anonymous-k1wi/Robot-CAD-Files/Plastic Antweight/Ike!/Photos/20250421_222257.jpg

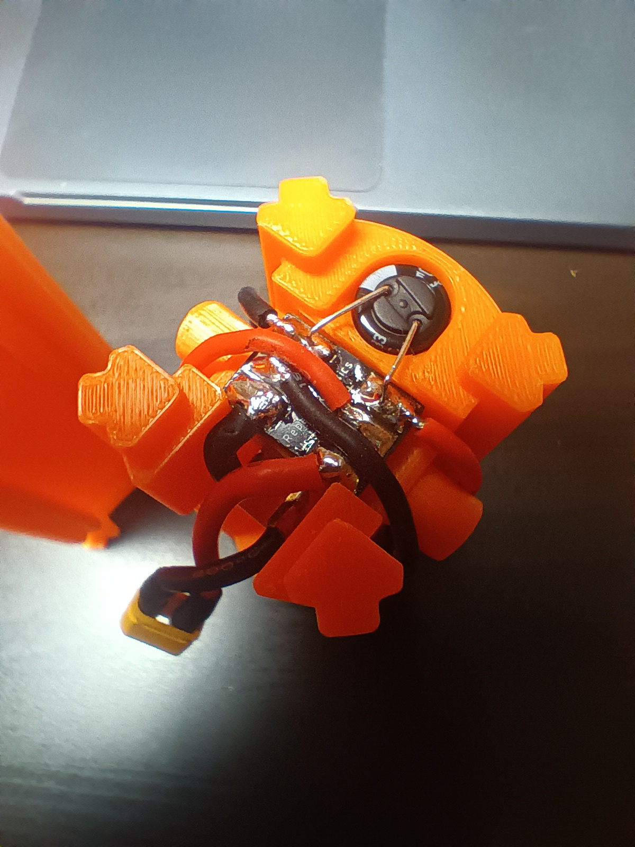
Plastic Antweight/Ike!/Photos/20250421_222257.jpg
