anonymous-k1wi/Robot-CAD-Files/Plastic Antweight/Ike!/Photos/20250419_141337.jpg

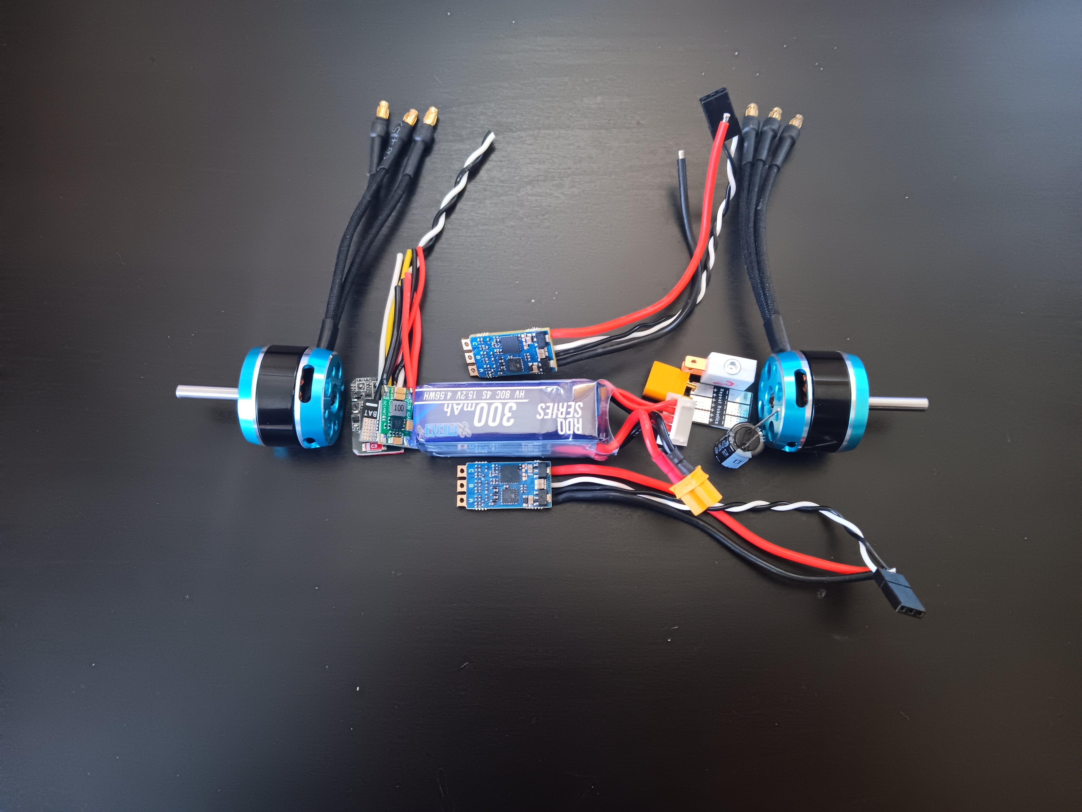
Plastic Antweight/Ike!/Photos/20250419_141337.jpg
