anonymous-k1wi/Robot-CAD-Files/Plastic Antweight/Citrus Twist/README.md

# Citrus Twist PLAnt Kit
This design was made and submitted to the [Repeat Robotics Open PLAnt Challenge](https://repeat-robotics.com/blogs/b/repeat-open-plant-challenge).  All electronics and hardware used to construct this kit can be found in the [Repeat Robotics Open PLAnt Bundle](https://repeat-robotics.com/products/open-plant-bundle), and all other parts are designed to be 3D printed from PLA+.



To get started, head to the [CAD & 3D Models](https://github.com/anonymous-k1wi/Robot-CAD-Files/tree/main/Plastic%20Antweight/Citrus%20Twist/CAD%20%26%203D%20Models) folder to download ready-to-go .3mf files (or individual .step files to setup and edit yourself), view the full CAD assembly, and download the [assembly manual](https://github.com/anonymous-k1wi/Robot-CAD-Files/blob/main/Plastic%20Antweight/Citrus%20Twist/Citrus%20Twist%20Assembly%20Manual.pdf).  Get building and have fun!

Has this been tested in the real world?  Yes!

Have you built this robot and want to have it added it to this list?  Make an RCE page and share the link and some pictures!



<sup> *[Momo](https://www.robotcombatevents.com/groups/5761/resources/39952)* </sup>
