anonymous-k1wi/Robot-CAD-Files/Plastic Antweight/Citrus Twist/CAD & 3D Models/Extras/Cast Wheels/README.md

These files are for those looking to forgo Lego wheels and make cast urethane wheels instead.
