anonymous-k1wi/Robot-CAD-Files/Plastic Antweight/Citrus Twist/CAD & 3D Models/Extras/2822 V2 Motor/README.md

If you have the older blue RR 2822 V2 motor, these files should be used instead of the main ones.  This is necessary due to the slightly altered mounting pattern for the screws.  All other parts remain the same.
