anonymous-k1wi/Robot-CAD-Files/Plastic Antweight/Citrus Twist/CAD & 3D Models/Basic Parts/README.md

# Citrus Twist Base Parts

## Recommended Print Settings

The print settings below are general recommended settings and are also contained in the .3mf files, but keep in mind they are intended to keep the robot slightly underweight by roughly ~20-25g.  After you've assembled and wired your first version and weighed the difference to the maximum weight (454g), add extra walls to the weapon ring to use up the remaining weight.  This will make the weapon stronger and hit harder.

| Part | Quantity | Wall Loops | Top/Bottom Layers | Infill Type | Infill % | Supports? | Approx. Weight (g) | 
| --- |:-:|:-:|:-:|:-:|:-:|:-:|:-:|
| core_lower.stp | 1x | 2 | 3 | Adaptive Cubic | 10% | No | 56g | 
| core_upper.stp | 1x | 2 | 3 | Adaptive Cubic | 10% | No | 25g | 
| weapon_ring.stp | 1x | 7 | 3 | Adaptive Cubic | 10% | Optional | 112g | 
| drive_gear.stp | 1x | 6 | 3 | Rectilinear | 40% | Yes | 13g |
| idler_gear.stp | 1x | 3 | 3 | Rectilinear | 40% | No | 3g | 
| wheel_hub.stp | 2x | 3 | 3 | Honeycomb | 10% | No | 5g |
| stabilizers.stp | 2x | 6 | 3 | Rectilinear | 40% | No | 2g |
| weapon_lock.stp | 1x | 4 | 3 | Rectilinear | 10% | No | NA |
