anonymous-k1wi/Robot-CAD-Files/Plastic Antweight/Citrus Twist/CAD & 3D Models/Basic Parts/Citrus Twist Assembly.stp

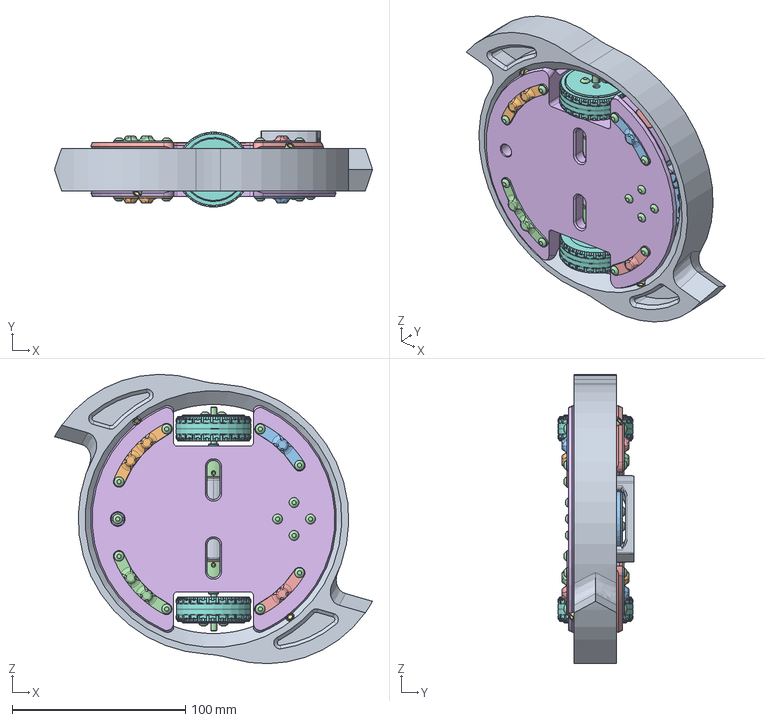
[picture p3: CAD file, 2026-10-29]
Plastic Antweight/Citrus Twist/CAD & 3D Models/Basic Parts/Citrus Twist Assembly.stp
183.3 x 43.8 x 166.8 mm
