anonymous-k1wi/Robot-CAD-Files/Plastic Antweight/Ike!/Ike_assembly.stp

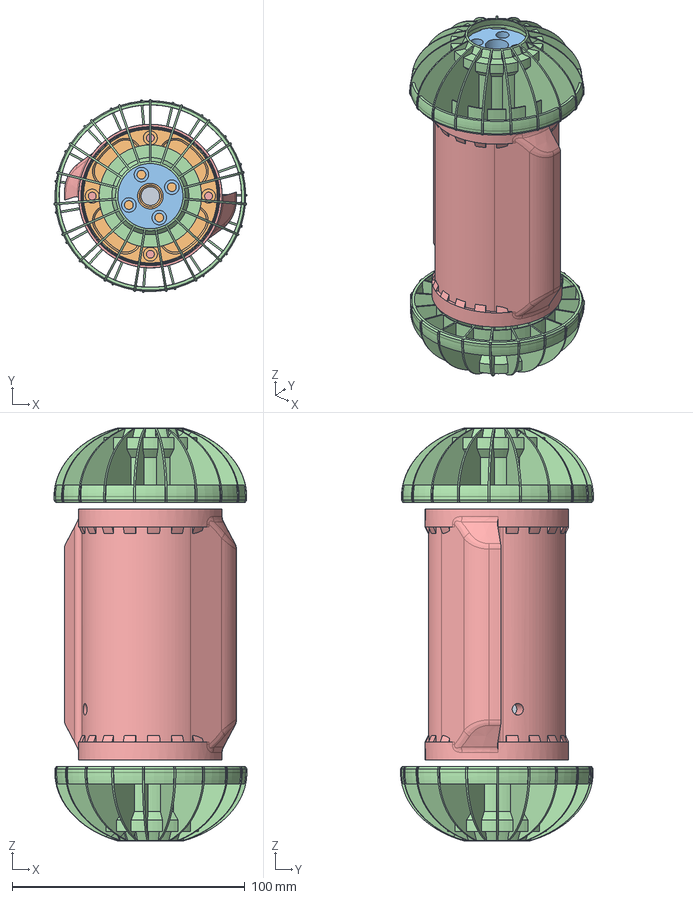
[picture p4: CAD file, 2026-06-19]
Plastic Antweight/Ike!/Ike_assembly.stp
82.9 x 82.9 x 177.5 mm
