anonymous-k1wi/Robot-CAD-Files/Plastic Antweight/Citrus Twist/CAD & 3D Models/Basic Parts/Individual Parts/weapon_lock.stp

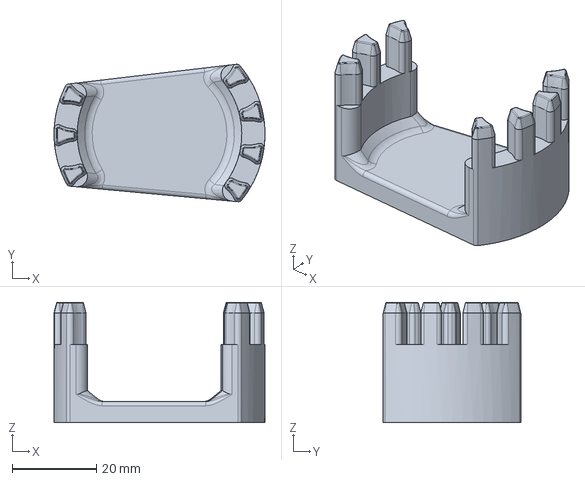
[picture p5: CAD file, 2026-10-29]
Plastic Antweight/Citrus Twist/CAD & 3D Models/Basic Parts/Individual Parts/weapon_lock.stp
50.0 x 32.6 x 28.5 mm
