anonymous-k1wi/Robot-CAD-Files/Plastic Antweight/Citrus Twist/CAD & 3D Models/Extras/2822 V2 Motor/drive_gear_mk2.stp

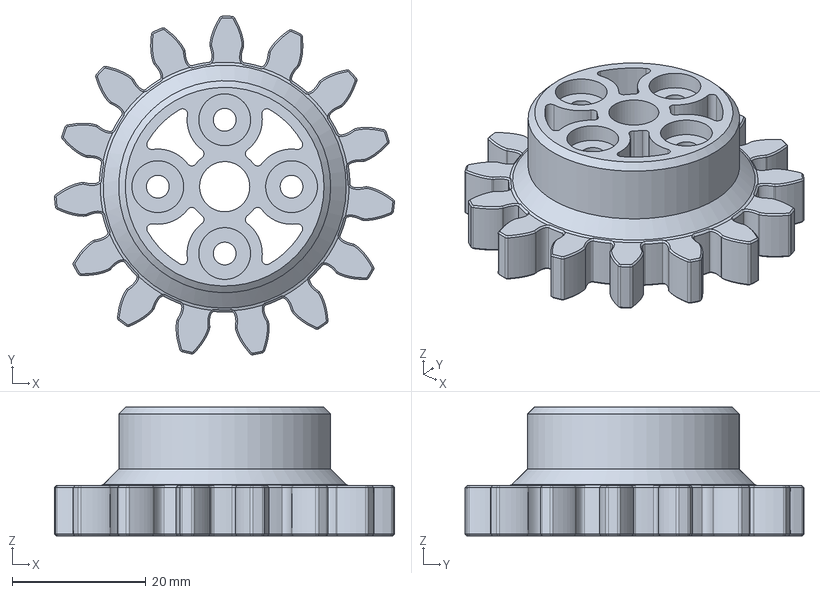
[picture p6: CAD file, 2026-11-01]
Plastic Antweight/Citrus Twist/CAD & 3D Models/Extras/2822 V2 Motor/drive_gear_mk2.stp
50.8 x 50.7 x 19.2 mm
