anonymous-k1wi/Robot-CAD-Files/Plastic Antweight/Citrus Twist/CAD & 3D Models/Extras/Cast Wheels/mold.stp

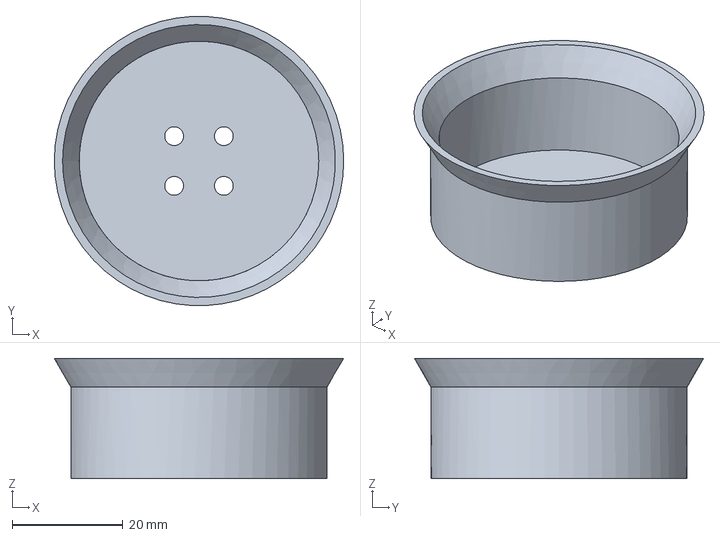
[picture p7: CAD file, 2026-11-01]
Plastic Antweight/Citrus Twist/CAD & 3D Models/Extras/Cast Wheels/mold.stp
52.3 x 52.2 x 21.7 mm
