anonymous-k1wi/Robot-CAD-Files/Plastic Antweight/Citrus Twist/CAD & 3D Models/Extras/display_stand.stp

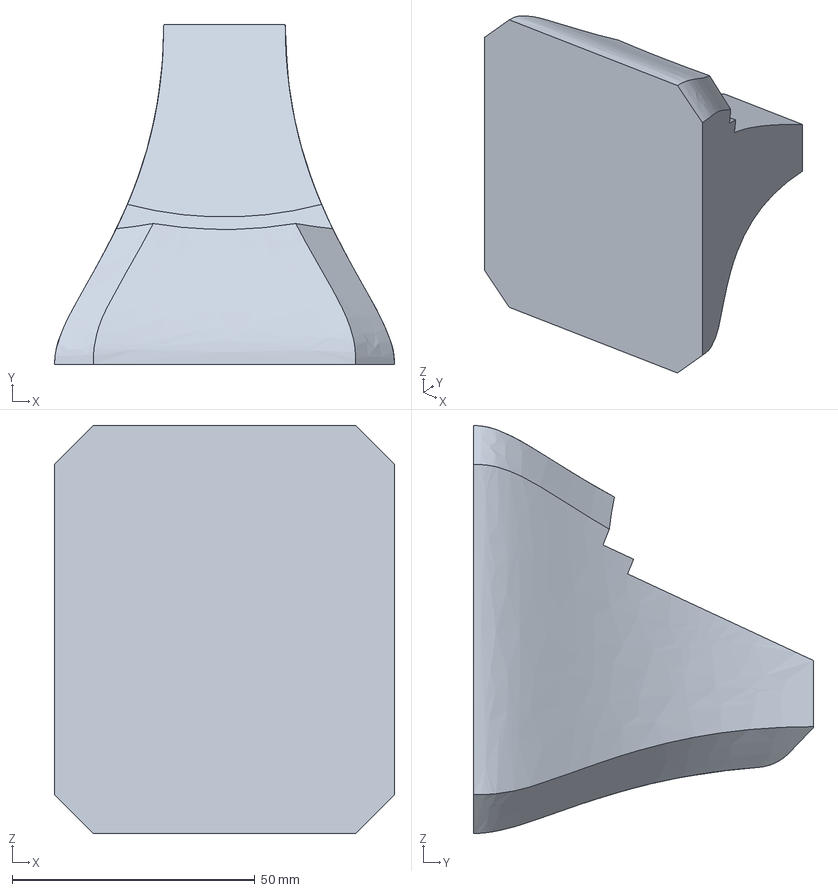
[picture p8: CAD file, 2026-10-30]
Plastic Antweight/Citrus Twist/CAD & 3D Models/Extras/display_stand.stp
70.0 x 70.0 x 84.0 mm
