anonymous-k1wi/Robot-CAD-Files/Plastic Antweight/Citrus Twist/CAD & 3D Models/Basic Parts/Citrus Twist Plate #2.published.3mf

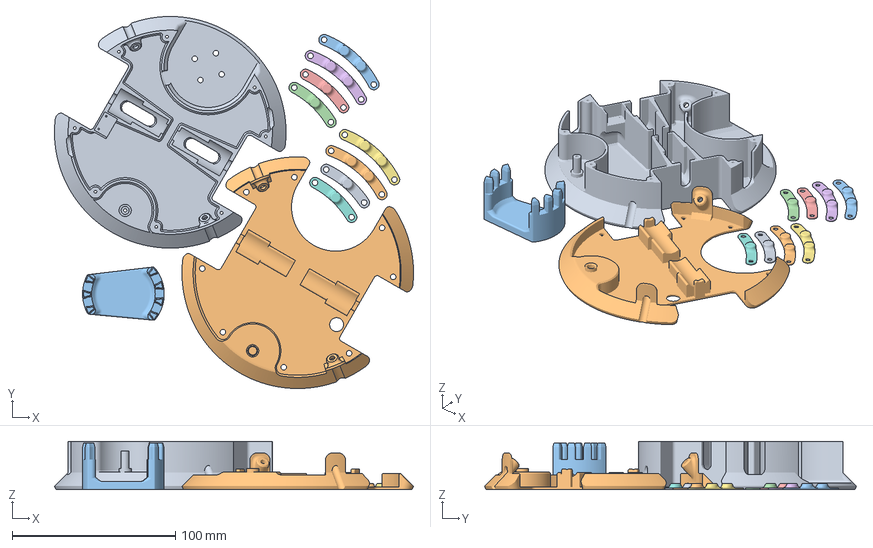
[picture p9: CAD file, 2026-10-29]
Plastic Antweight/Citrus Twist/CAD & 3D Models/Basic Parts/Citrus Twist Plate #2.published.3mf
219.8 x 227.7 x 29.5 mm
core_lower.stp
core_upper.stp
stabilizers.stp_1 x 2
stabilizers.stp_2 x 2
stabilizers.stp_3 x 2
stabilizers.stp_4 x 2
weapon_lock.stp
