anonymous-k1wi/Robot-CAD-Files/Plastic Antweight/Citrus Twist/CAD & 3D Models/Basic Parts/Individual Parts/idler_gear.stp

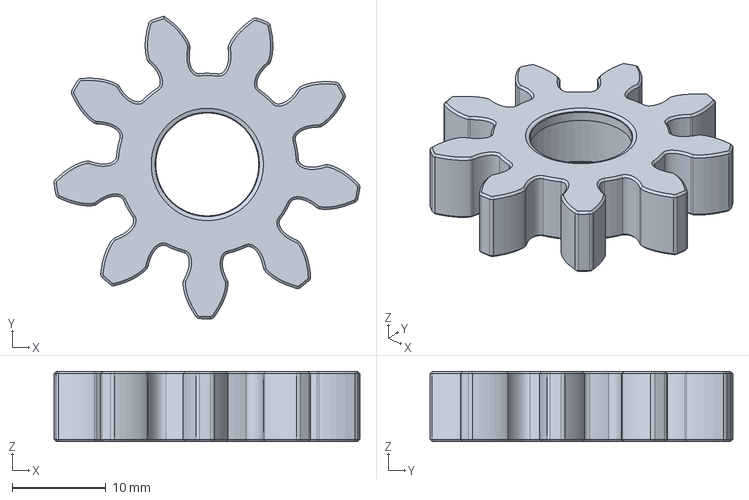
[picture p10: CAD file, 2026-10-29]
Plastic Antweight/Citrus Twist/CAD & 3D Models/Basic Parts/Individual Parts/idler_gear.stp
32.7 x 32.3 x 7.50 mm
