anonymous-k1wi/Robot-CAD-Files/Plastic Antweight/Citrus Twist/CAD & 3D Models/Extras/2822 V2 Motor/core_lower_mk2.stp

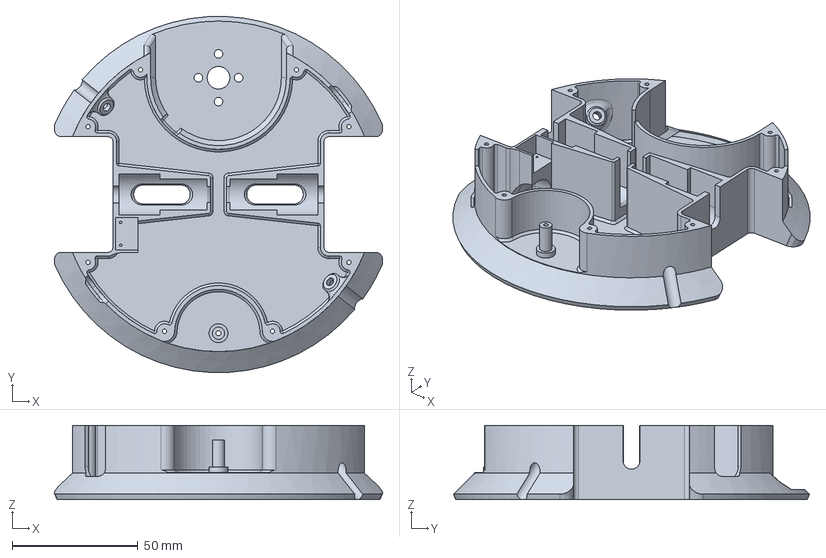
[picture p11: CAD file, 2026-11-01]
Plastic Antweight/Citrus Twist/CAD & 3D Models/Extras/2822 V2 Motor/core_lower_mk2.stp
130.7 x 141.6 x 29.5 mm
