anonymous-k1wi/Robot-CAD-Files/Plastic Antweight/Citrus Twist/CAD & 3D Models/Extras/Cast Wheels/wheel_hub_cast.stp

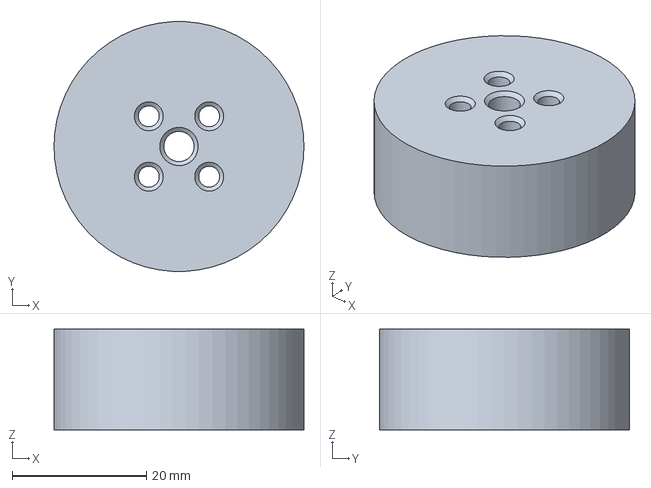
[picture p12: CAD file, 2026-11-01]
Plastic Antweight/Citrus Twist/CAD & 3D Models/Extras/Cast Wheels/wheel_hub_cast.stp
37.2 x 37.1 x 15.0 mm
