anonymous-k1wi/Robot-CAD-Files/Plastic Antweight/Citrus Twist/CAD & 3D Models/Extras/core_upper_base.stp

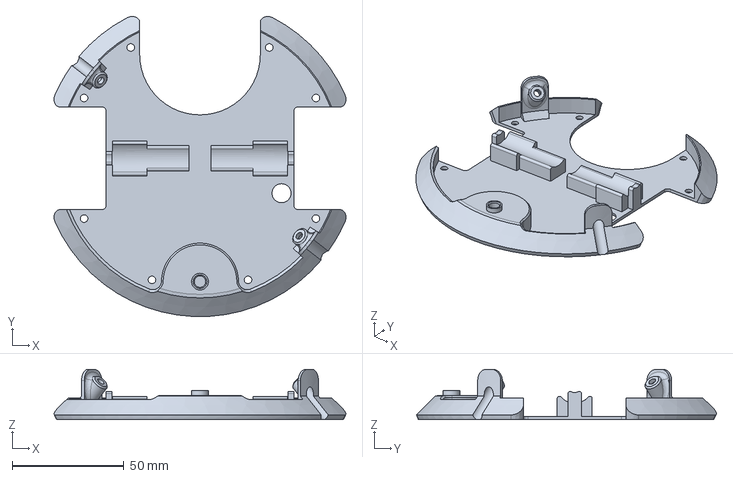
[picture p13: CAD file, 2026-10-29]
Plastic Antweight/Citrus Twist/CAD & 3D Models/Extras/core_upper_base.stp
130.7 x 134.3 x 22.5 mm
