anonymous-k1wi/Robot-CAD-Files/Plastic Antweight/Citrus Twist/CAD & 3D Models/Basic Parts/Citrus Twist Plate #1.published.3mf

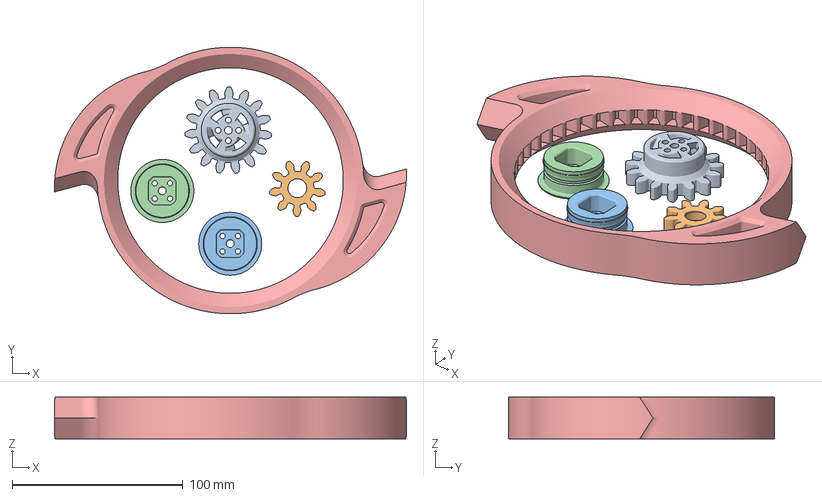
[picture p14: CAD file, 2026-10-29]
Plastic Antweight/Citrus Twist/CAD & 3D Models/Basic Parts/Citrus Twist Plate #1.published.3mf
206.1 x 156.0 x 24.5 mm
drive_gear.stp
idler_gear.stp
wheel_hub.stp x 2
weapon_ring.stp
