anonymous-k1wi/Robot-CAD-Files/Plastic Antweight/Citrus Twist/CAD & 3D Models/Basic Parts/Individual Parts/drive_gear.stp

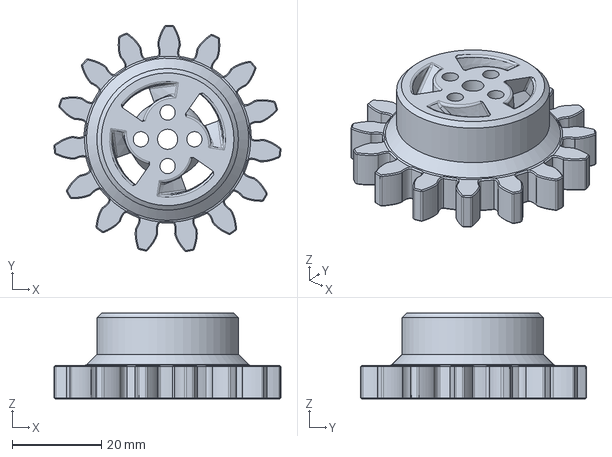
[picture p15: CAD file, 2026-10-29]
Plastic Antweight/Citrus Twist/CAD & 3D Models/Basic Parts/Individual Parts/drive_gear.stp
50.8 x 50.7 x 19.3 mm
