anonymous-k1wi/Robot-CAD-Files/Plastic Antweight/Citrus Twist/CAD & 3D Models/Extras/Cast Wheels/gyroid.stp

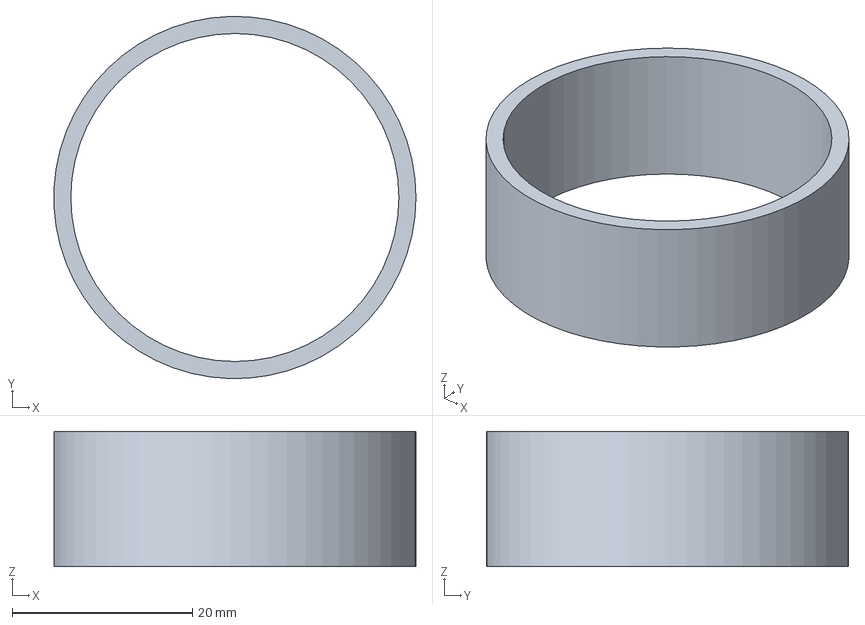
[picture p16: CAD file, 2026-11-01]
Plastic Antweight/Citrus Twist/CAD & 3D Models/Extras/Cast Wheels/gyroid.stp
40.2 x 40.2 x 15.0 mm
