anonymous-k1wi/Robot-CAD-Files/Plastic Antweight/Citrus Twist/CAD & 3D Models/Extras/weapon_ring_base.stp

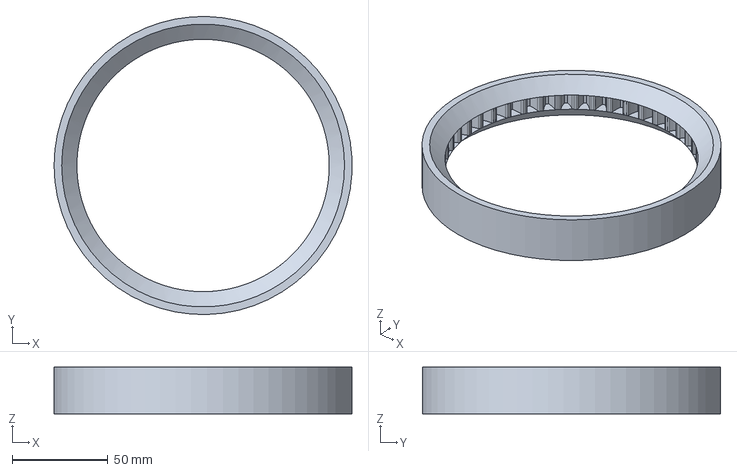
[picture p17: CAD file, 2026-10-29]
Plastic Antweight/Citrus Twist/CAD & 3D Models/Extras/weapon_ring_base.stp
155.9 x 155.9 x 24.5 mm
