anonymous-k1wi/Robot-CAD-Files/Plastic Antweight/Citrus Twist/CAD & 3D Models/Basic Parts/Individual Parts/stabilizers.stp

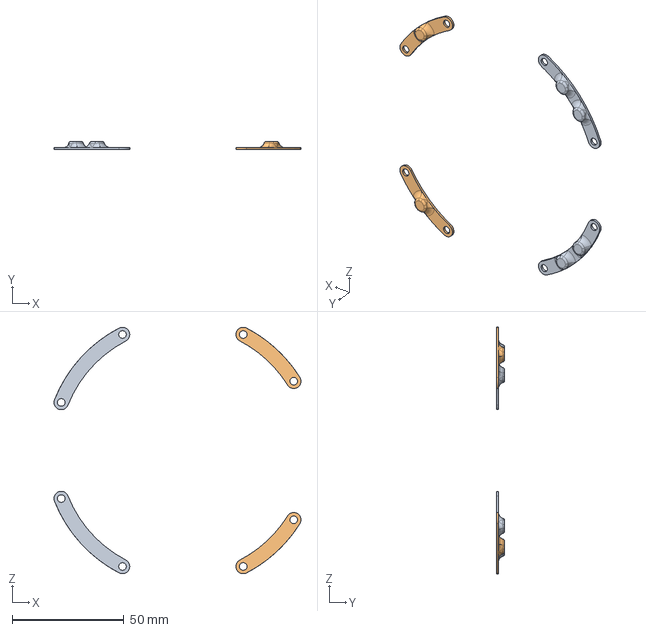
[picture p18: CAD file, 2026-10-29]
Plastic Antweight/Citrus Twist/CAD & 3D Models/Basic Parts/Individual Parts/stabilizers.stp
110.5 x 3.75 x 110.3 mm
