anonymous-k1wi/Robot-CAD-Files/Plastic Antweight/Citrus Twist/CAD & 3D Models/Basic Parts/Individual Parts/wheel_hub.stp

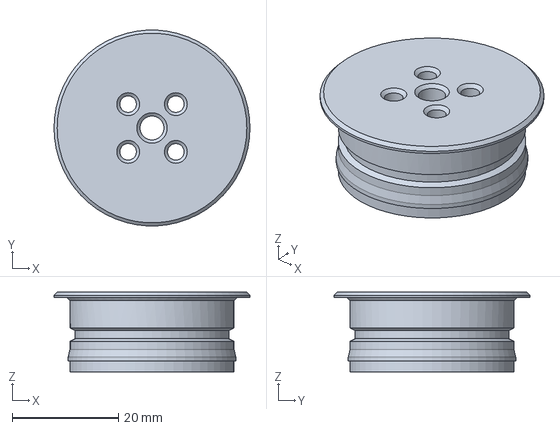
[picture p19: CAD file, 2026-10-29]
Plastic Antweight/Citrus Twist/CAD & 3D Models/Basic Parts/Individual Parts/wheel_hub.stp
36.9 x 36.8 x 15.0 mm
