anonymous-k1wi/Robot-CAD-Files/(list of files, cad)

Other CAD files:
Plastic Antweight/Citrus Twist/CAD & 3D Models/Basic Parts/Individual Parts/core_upper.stp
