anonymous-k1wi/Robot-CAD-Files/(commit log)

2026-06-19 Rename Ike_assembly.stp to Plastic Antweight/Ike!/Ike_assembly.stp
    [Ike_assembly.stp]
2026-10-29 Add files via upload
    full assembly .stp file
    [Citrus Twist Assembly.stp]
2026-11-01 Create Cast Wheels
